openspaceaarhus/PhotonSaw/misc/microsd.png

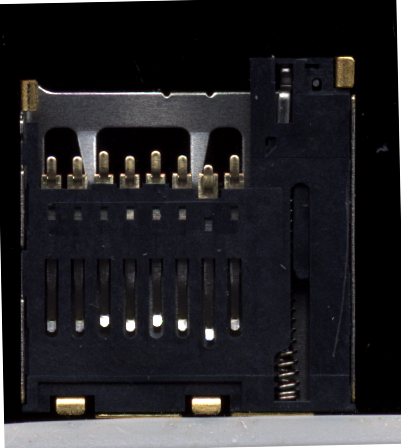
misc/microsd.png
