openspaceaarhus/PhotonSaw/laserctrl/output/tapeout-2011-12-18/pcb-scans.jpeg

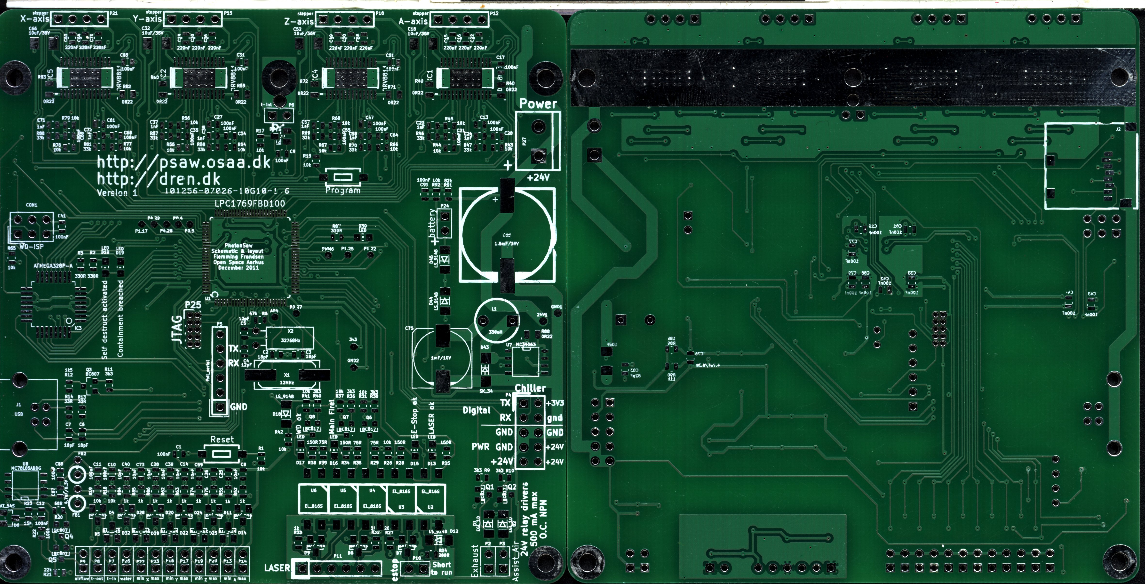
laserctrl/output/tapeout-2011-12-18/pcb-scans.jpeg
