openspaceaarhus/PhotonSaw/README

This is the source tree for the OSAA Laser Cutter, named PhotonSaw.
