openspaceaarhus/PhotonSaw/bulkhead/readme.txt

This is a breakout board which is mounted in the bulkhead between
the electronics comparment and the cutting comparment.

It allows all the connections from the cutting system to be terminated at
the same place and it makes the connection air tight.
