openspaceaarhus/PhotonSaw/host/casing/readme.txt

The engraving on the case does not end up in the correct location,
but all the cuts do.
