openspaceaarhus/PhotonSaw/host/hardware-notes.txt

Screen on hand:
 Samsung 204b: 30.1 x 41.3 cm
 Need a touch panel.
