openspaceaarhus/PhotonSaw/chassis/plates/ready/list.txt

lift.plate.svg				4x	4 mm Al
motor-mount.plate.svg			7x	4 mm Al
idler.plate.svg				6x	4 mm Al
lift-bottom-left.plate.svg		2x	4 mm Al
lift-bottom-right.plate.svg		2x	4 mm Al
x-end.plate.svg				2x	4 mm Al
x-plate.svg				1x	4 mm Al
mirror-1.plate.svg			1x	4 mm Al
mirror-2-x.plate.svg			1x	4 mm Al
mirror-2-z.plate.svg			1x	4 mm Al
mirror-3.plate.svg			1x	4 mm Al
laserctrl-cooling.plate.svg		1x	4 mm Al

tube-mount.plate.svg			2x	6 mm plastic (Nylon/POM/ABS)
