openspaceaarhus/PhotonSaw/chassis/cutlist.ods

Type | Qty | Length
Big | 2 | 1875 | 3750
Big | 2 | 740 | 1480 | 5230 | 1.7433333333
Lit | 2 | 430 | 860
Lit | 2 | 590 | 1180
Lit | 6 | 740 | 4440
Lit | 6 | 1875 | 11250
Lit | 2 | 160 | 320
Lit | 2 | 220 | 440 | 18490 | 6.1633333333
