openspaceaarhus/PhotonSaw/chassis/ramme-v1.1.png

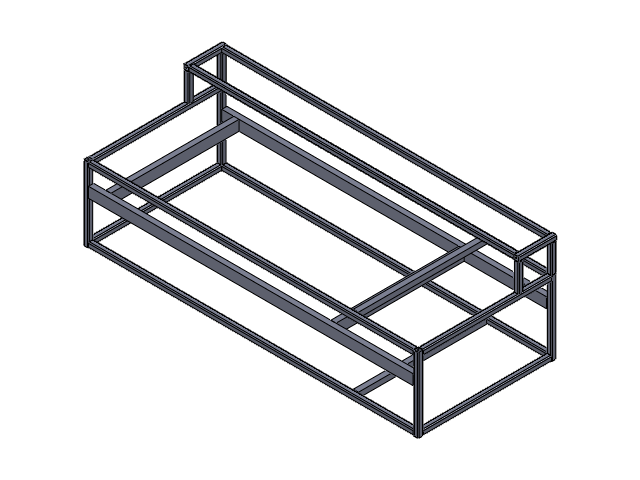
chassis/ramme-v1.1.png
