openspaceaarhus/PhotonSaw/misc/lasercrtl-bom.ods

Sheet: Sheet1
Value | Parts | SKU | # | 1 pcs | n pcs | URL | Extended price
Need from ELFA
mini-sw-CB00.5 | SW1, SW2 | 35-603-98 | 2 | 2.69 | 1.2 | https://www.elfa.se/elfa3~dk_en/elfa/init.do?item=35-603-98 | 2.4
USB USB_B | J1 | 42-707-40 | 1 | 12.1 | 6.64 | https://www.elfa.se/elfa3~dk_en/elfa/init.do?item=42-707-40 | 6.64
MICROSD microSD | J2 | 48-081-00 | 1 | 16 | 12.5 | https://www.elfa.se/elfa3~dk_en/elfa/init.do?item=48-081-00 | 12.5
Power bornier2 | P27 | 48-410-87 | 1 | 5.08 | 3.96 | https://www.elfa.se/elfa3~dk_en/elfa/init.do?item=48-410-87 | 3.96
330uH INDUCTOR_V | L1 | 58-578-19 | 1 | 11.3 | 7.09 | https://www.elfa.se/elfa3~dk_en/elfa/init.do?item=58-578-19 | 7.09
FILTER axial | FB1 FB2 | 58-727-59 | 2 | 1.8 | 1.12 | https://www.elfa.se/elfa3~dk_en/elfa/init.do?item=58-727-59 | 2.24
100k 0603 | R22 | 60-352-40 | 100 | 0.0075 | 0.0075 | https://www.elfa.se/elfa3~dk_en/elfa/init.do?item=60-352-40 | 0.75
150R 0603 | R25 R28 R34 R38 | 60-352-65 | 100 | 0.0075 | 0.0075 | https://www.elfa.se/elfa3~dk_en/elfa/init.do?item=60-352-65 | 0.75
33R 0603 | R13 R14 | 60-596-69 | 2 | 0.555 | 0.276 | https://www.elfa.se/elfa3~dk_en/elfa/init.do?item=60-596-69 | 0.552
68R 0603 | R20 | 60-596-77 | 1 | 0.555 | 0.276 | https://www.elfa.se/elfa3~dk_en/elfa/init.do?item=60-596-77 | 0.276
75R 0603 | R29 R35 R39 | 60-596-78 | 3 | 0.555 | 0.276 | https://www.elfa.se/elfa3~dk_en/elfa/init.do?item=60-596-78 | 0.828
200R 0603 | R24 R27 | 60-596-88 | 2 | 0.555 | 0.276 | https://www.elfa.se/elfa3~dk_en/elfa/init.do?item=60-596-88 | 0.552
330R 0603 | R2 R3 R87 | 60-596-93 | 3 | 0.555 | 0.276 | https://www.elfa.se/elfa3~dk_en/elfa/init.do?item=60-596-93 | 0.828
1k 0603 | R32 R33 R51 R52 R62 R63 R74 R75 R85 R86 R94 | 60-597-05 | 100 | 0.555 | 0.276 | https://www.elfa.se/elfa3~dk_en/elfa/init.do?item=60-597-05 | 27.6
1k5 0603 | R12 | 60-597-09 | 1 | 0.555 | 0.276 | https://www.elfa.se/elfa3~dk_en/elfa/init.do?item=60-597-09 | 0.276
3k3 0603 | R9 R10 R11 R30 R36 R40 | 60-597-17 | 6 | 0.555 | 0.276 | https://www.elfa.se/elfa3~dk_en/elfa/init.do?item=60-597-17 | 1.656
10k 0603 | R1 R15 R17 R18 R19 R26 R31 R37 R41 R42 R43 R44 R45 R54 R55 R56 R65 R66 R67 R68 R77 R78 R79 R92 | 60-597-29 | 100 | 0.555 | 0.276 | https://www.elfa.se/elfa3~dk_en/elfa/init.do?item=60-597-29 | 27.6
11k 0603 | R90 | 60-597-30 | 1 | 0.555 | 0.276 | https://www.elfa.se/elfa3~dk_en/elfa/init.do?item=60-597-30 | 0.276
15k 0603 | R23 | 60-597-33 | 1 | 0.555 | 0.276 | https://www.elfa.se/elfa3~dk_en/elfa/init.do?item=60-597-33 | 0.276
18k 0603 | R89 | 60-597-35 | 1 | 0.555 | 0.276 | https://www.elfa.se/elfa3~dk_en/elfa/init.do?item=60-597-35 | 0.276
22k 0603 | R21 | 60-597-37 | 1 | 0.555 | 0.276 | https://www.elfa.se/elfa3~dk_en/elfa/init.do?item=60-597-37 | 0.276
33k 0603 | R46 R47 R57 R58 R69 R70 R80 R81 | 60-597-41 | 8 | 0.555 | 0.276 | https://www.elfa.se/elfa3~dk_en/elfa/init.do?item=60-597-41 | 2.208
47k 0603 | R6 | 60-597-45 | 1 | 0.555 | 0.276 | https://www.elfa.se/elfa3~dk_en/elfa/init.do?item=60-597-45 | 0.276
82k 0603 | R91 | 60-597-51 | 1 | 0.555 | 0.276 | https://www.elfa.se/elfa3~dk_en/elfa/init.do?item=60-597-51 | 0.276
100nF 0603 | C1 C9 C10 C11 C12 C13 C17 C19 C20 C21 C27 C31 C33 C34 C35 C41 C42 C43 C44 C47 C51 C54 C55 C61 C65 C68 C69 C77 C79 C81 C88 C89 C91 | 65-200-01 | 100 | 0.209 | 0.0963 | https://www.elfa.se/elfa3~dk_en/elfa/init.do?item=65-200-01 | 9.63
220nF 0603 | C15 C16 C22 C29 C30 C36 C49 C50 C56 C63 C64 C70 | 65-721-02 | 12 | 0.788 | 0.411 | https://www.elfa.se/elfa3~dk_en/elfa/init.do?item=65-721-02 | 4.932
4.7uF/6.3V 0603 | C76 C87 | 65-721-05 | 2 | 1.14 | 0.593 | https://www.elfa.se/elfa3~dk_en/elfa/init.do?item=65-721-05 | 1.186
12pF 0603 | C4 C5 | 65-750-05 | 2 | 2.21 | 0.183 | https://www.elfa.se/elfa3~dk_en/elfa/init.do?item=65-750-05 | 0.366
18pF 0603 | C2 C3 C6 C7 | 65-750-47 | 4 | 1.76 | 0.146 | https://www.elfa.se/elfa3~dk_en/elfa/init.do?item=65-750-47 | 0.584
82pF 0603 | C83 | 65-752-03 | 1 | 2.13 | 0.176 | https://www.elfa.se/elfa3~dk_en/elfa/init.do?item=65-752-03 | 0.176
1nF 0603 | C23 C24 C37 C38 C57 C58 C71 C72 | 65-804-11 | 8 | 0.175 | 0.0657 | https://www.elfa.se/elfa3~dk_en/elfa/init.do?item=65-804-11 | 0.5256
10nF 0603 | C8 C14 C25 C26 C28 C39 C40 C59 C73 | 65-804-17 | 100 | 0.175 | 0.0657 | https://www.elfa.se/elfa3~dk_en/elfa/init.do?item=65-804-17 | 6.57
1mF/10V c_elec_10x10 | C75 | 67-226-56 | 1 | 6.72 | 2.99 | https://www.elfa.se/elfa3~dk_en/elfa/init.do?item=67-226-56 | 2.99
1.5mF/35V c_elec_16x16 | C85 | 67-226-96 | 4 | 1.87 | 1.27 | https://www.elfa.se/elfa3~dk_en/elfa/init.do?item=67-226-96 | 5.08
SK34 diode-SMA | D43 | 70-087-07 | 1 | 1.2 | 0.75 | https://www.elfa.se/elfa3~dk_en/elfa/init.do?item=70-087-07 | 0.75
BAT54S diode-SOT23 | D3 D4 D5 D6 D7 D8 D9 D11 D14 D20 D22 D24 D25 D28 D29 D32 | 70-181-38 | 20 | 0.83 | 0.53 | https://www.elfa.se/elfa3~dk_en/elfa/init.do?item=70-181-38 | 10.6
EGL 1D | D1 D2 | 70-035-47 | 6 |  | 0.53 | https://www.elfa.se/elfa3~dk_en/elfa/init.do?item=70-035-38 | 3.18
LS914B diode-minimelf | D12 D18 D44 D45 | 70-186-09 | 10 | 0.42 | 0.21 | https://www.elfa.se/elfa3~dk_en/elfa/init.do?item=70-186-09 | 2.1
BC817 SOT23-bec | Q1 Q2 Q6 Q7 Q8 | 71-311-95 | 10 | 0.338 | 0.233 | https://www.elfa.se/elfa3~dk_en/elfa/init.do?item=71-311-95 | 2.33
BC807 SOT23-bec | Q3 Q4 Q5 | 71-311-98 | 10 | 0.409 | 0.281 | https://www.elfa.se/elfa3~dk_en/elfa/init.do?item=71-311-98 | 2.81
MC78L05ABDG SO8N | U8 | 73-286-67 | 2 | 3.06 | 2.24 | https://www.elfa.se/elfa3~dk_en/elfa/init.do?item=73-286-67 | 4.48
32768Hz QMONTRE | X2 | 74-518-95 | 1 | 2.84 | 1.57 | https://www.elfa.se/elfa3~dk_en/elfa/init.do?item=74-518-95 | 1.57
12MHz Q_49U3HMS | X1 | 74-528-02 | 1 | 9.55 | 5.75 | https://www.elfa.se/elfa3~dk_en/elfa/init.do?item=74-528-02 | 5.75
LED LED-0805 | D10 D13 D15 D16 D17 D19 D30 | 75-102-55 | 10 | 0.88 | 0.52 | https://www.elfa.se/elfa3~dk_en/elfa/init.do?item=75-102-55 | 5.2
EL816S(TA) dip-4 | U2 U3 U4 U5 U6 | 75-390-25 | 5 | 2.24 | 1.35 | https://www.elfa.se/elfa3~dk_en/elfa/init.do?item=75-390-25 | 6.75
JTAG header-1.27mm-2x5 | P25 | 43-914-12 | 2 |  | 6.2 | https://www.elfa.se/elfa3~dk_en/elfa/init.do?item=43-914-12 | 12.4
JTAG socket | n/a | 43-914-00 | 2 |  | 8.58 | https://www.elfa.se/elfa3~dk_en/elfa/init.do?item=43-914-00 | 17.16
1x2 socket | n/a | 43-566-06 | 30 |  | 0.441 | https://www.elfa.se/elfa3~dk_en/elfa/init.do?item=43-566-06 | 13.23
1x4 socket | n/a | 43-566-10 | 10 |  | 0.852 |  | 8.52
1x6 socket | n/a | 43-566-14 | 3 |  | 1.23 |  | 3.69
crimp socket | n/a | 43-010-16 | 128 |  | 0.367 |  | 46.976
Wire – black | n/a | 55-228-00 | 50 |  | 1.35 |  | 67.5
Wire – brown | n/a | 55-228-18 | 50 |  | 1.35 |  | 67.5
Wire – red | n/a | 55-228-26 | 50 |  | 1.35 |  | 67.5
Wire – Orange | n/a | 55-228-34 | 50 |  | 1.35 |  | 67.5
Wire – Yellow | n/a | 55-228-42 | 25 |  | 1.35 |  | 33.75
Wire – Green | n/a | 55-228-59 | 25 |  | 1.35 |  | 33.75
Spiral sleeve | n/a | 55-002-10 | 1 |  | 64.8 |  | 64.8
 |  |  |  |  |  |  | 0
 |  |  |  |  |  |  | 0
 |  |  |  |  |  |  | 0
 |  |  |  |  |  |  | 0
 |  |  |  |  |  |  | 0
 |  |  |  |  |  |  | 0
Need from mouser: |  |  |  |  |  |  | 0
LPC1769FBD100 TQFP_100 | U1 | 771-LPC1769FBD100551 | 1 |  | 58.238 | http://eu.mouser.com/ProductDetail/NXP/LPC1769FBD100551/?qs=sSXnapcmqSv%252bz8p9xNDnBw%3d%3d | 58.238
10uF/35V 1206 | C18 C32 C52 C66 C84 | 810-C3216X6S1V106M | 5 |  | 2.14 | http://eu.mouser.com/ProductDetail/TDK/C3216X6S1V106M/ | 10.7
 |  |  |  |  |  |  | 0
Have from mouser |  |  |  |  |  |  | 0
DRV8811 HTSSOP | IC1 IC2 IC4 IC5 | 595-DRV8811PWP | 4 |  | 37.592 | http://eu.mouser.com/ProductDetail/Texas-Instruments/DRV8811PWP/?qs=sGAEpiMZZMs7zYnFw9eWkg2x1%252beWxeL7 | 150.368
ATMEGA328P-A TQFP32 | IC3 | 556-ATMEGA328P-AU | 1 |  | 31.524 | http://eu.mouser.com/ProductDetail/Atmel/ATMEGA328P-AU/?qs=sGAEpiMZZMtVoztFdqDXO3RbBx7FKCmV | 31.524
0R22 0805 | R48 R49 R59 R60 R71 R72 R82 R83 R88 | have | 9 |  | 0.9176 | http://eu.mouser.com/ProductDetail/Panasonic-Electronic-Components/ERJ-6BQFR22V/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 | 8.2584
 |  |  |  |  |  |  | 0
 |  |  |  |  |  |  | 0
Have from ebay |  |  |  |  |  |  | 0
MC34063 SO8N | U7 | have | 1 |  | 5 | ebay | 5
 |  |  |  |  |  | Total | 946.286
 |  |  |  |  |  | Total incl. Moms | 1182.8575

Sheet: Sheet2
SKU | # | a | Pris | Value
35-603-98 | 2 | 1.2 | 2.4 | mini-sw-CB00.5
42-707-40 | 1 | 6.64 | 6.64 | USB USB_B
48-081-00 | 1 | 12.5 | 12.5 | MICROSD microSD
48-375-06 | 1 | 3.96 | 3.96 | Power bornier2 | Blargh
58-578-29 | 1 | 7.09 | 7.09 | 330uH INDUCTOR_V | Blargh
58-727-59 | 2 | 1.12 | 2.24 | FILTER axial
60-352-40 | 100 | 0.0075 | 0.75 | 100k 0603
60-352-65 | 100 | 0.0075 | 0.75 | 150R 0603
60-596-69 | 2 | 0.276 | 0.552 | 33R 0603
60-596-77 | 1 | 0.276 | 0.276 | 68R 0603 | Mangler
60-596-78 | 3 | 0.276 | 0.828 | 75R 0603
60-596-88 | 2 | 0.276 | 0.552 | 200R 0603
60-596-93 | 3 | 0.276 | 0.828 | 330R 0603
60-597-05 | 100 | 0.276 | 27.6 | 1k 0603
60-597-09 | 1 | 0.276 | 0.276 | 1k5 0603
60-597-17 | 6 | 0.276 | 1.656 | 3k3 0603
60-597-29 | 100 | 0.276 | 27.6 | 10k 0603
60-597-30 | 1 | 0.276 | 0.276 | 11k 0603
60-597-33 | 1 | 0.276 | 0.276 | 15k 0603
60-597-35 | 1 | 0.276 | 0.276 | 18k 0603
60-597-37 | 1 | 0.276 | 0.276 | 22k 0603
60-597-41 | 8 | 0.276 | 2.208 | 33k 0603
60-597-45 | 1 | 0.276 | 0.276 | 47k 0603
60-597-51 | 1 | 0.276 | 0.276 | 82k 0603
65-200-01 | 100 | 0.0963 | 9.63 | 100nF 0603
65-721-02 | 12 | 0.411 | 4.932 | 220nF 0603
65-721-05 | 2 | 0.593 | 1.186 | 4.7uF/6.3V 0603
65-750-05 | 2 | 0.183 | 0.366 | 12pF 0603
65-750-47 | 4 | 0.146 | 0.584 | 18pF 0603
 | 1 | 0.176 | 0.176 | 82pF 0603 | Blargh stak: af 2x47 pF (65-754-72)
65-804-11 | 8 | 0.0657 | 0.5256 | 1nF 0603
65-804-17 | 100 | 0.0657 | 6.57 | 10nF 0603
67-226-56 | 1 | 2.99 | 2.99 | 1mF/10V c_elec_10x10
67-226-96 | 4 | 1.27 | 5.08 | 1.5mF/35V c_elec_16x16
70-087-07 | 1 | 0.75 | 0.75 | SK34 diode-SMA | Mangler
70-181-38 | 20 | 0.53 | 10.6 | BAT54S diode-SOT23
70-035-47 | 6 | 0.53 | 3.18 | EGL 1D
70-186-09 | 10 | 0.21 | 2.1 | LS914B diode-minimelf
71-311-95 | 10 | 0.233 | 2.33 | BC817 SOT23-bec
71-303-62 | 10 | 0.51 | 5.1 | BC807 SOT23-bec | Blargh
73-286-67 | 2 | 2.24 | 4.48 | MC78L05ABDG SO8N
74-518-95 | 1 | 1.57 | 1.57 | 32768Hz QMONTRE
74-528-02 | 1 | 5.75 | 5.75 | 12MHz Q_49U3HMS
75-102-55 | 10 | 0.52 | 5.2 | LED LED-0805
75-390-25 | 5 | 1.35 | 6.75 | EL816S(TA) dip-4
43-914-12 | 2 | 6.2 | 12.4 | JTAG header-1.27mm-2x5
43-914-00 | 2 | 8.58 | 17.16 | JTAG socket
43-566-06 | 30 | 0.441 | 13.23 | 1x2 socket
43-566-10 | 10 | 0.852 | 8.52 | 1x4 socket
43-566-14 | 3 | 1.23 | 3.69 | 1x6 socket
43-010-16 | 128 | 0.367 | 46.976 | crimp socket
55-228-00 | 50 | 1.35 | 67.5 | Wire – black
55-228-18 | 50 | 1.35 | 67.5 | Wire – brown
55-228-26 | 50 | 1.35 | 67.5 | Wire – red
55-228-34 | 50 | 1.35 | 67.5 | Wire – Orange
55-228-42 | 25 | 1.35 | 33.75 | Wire – Yellow
55-228-59 | 25 | 1.35 | 33.75 | Wire – Green
55-002-10 | 1 | 64.8 | 64.8 | Spiral sleeve
 | Total |  | 684.4876
 | Incl. Moms | moms | 855.6095
