openspaceaarhus/PhotonSaw/misc/expenses-and-sources.ods

Sheet: Expences
ID | Subsystem | Part | Budget | Actual | Paid by
./rain | LASER+cooling | LASER + PSU + spare optics |  | 4000 | Cash
2021 |  | Transport of LASER |  | 1050 | ff | Bridge and fuel
2022 |  | HV wire |  | 145 | ff
2023 |  | Water cooling fittings |  | 125 | ff
2024 |  | Flow sensor |  | 200 | ff
2025 |  | Pump |  | 434 | ff
2026 |  | More fittings |  | 362 | ff
2027 |  | Hose clamps |  | 85 | ff | Brix bought them
2028 |  | Pump + fittings for chiller |  | 848 | ff | This should be the last cooling gear needed.
2050 |  | Yet more fittings |  | 143 | ff | ... no this is.
2051 |  | Yet more fittings |  | 121 | ff | ... no this!
2052 |  | Tank 2.5 L |  | 63.75 | ff
2053 |  | Insulation |  | 89 | ff
2054 |  | rubber gaskets |  | 38 | ff
2055 |  | HN safety glasses |  | 130 | ff
2029 | Optics | Optics kit from Ebay |  | 1462 | ff | Got it – 1 mirror
 | Mechanics
2030 |  | V-rails from Klee |  | 1080 | ff | http://www.klee.dk/catalog/group/nodeid/dualv_skin
2031 |  | V-groove bearings |  | 540 | ff | http://www.vxb.com/page/bearings/PROD/Kit8351
2032 |  | MayTec – profiles |  | 3353 | ff
2033 |  | MayTec – connectors |  | 1121 | ff | http://www.maytec.org/mainframe_e.htm
2034 |  | Toothed belts and pulleys |  | 730 | ff | http://www.mobra.biz/sw/frontend/show.asp?parent=151030&layout=0
2144 |  | IGUS cable chains |  | 323 | ff
 |  | PETG windows | 620 |  |  | BS plast
 |  | Skins (1mm alu) | 1630 |  |  | Sanistål
2035 | OSB møbel | 5x OSB + 4x Reglar + Skruer |  | 732.22 | ff
2036 | Tools | Lathe tools |  | 386 | ff
2037 |  | Misc tools (HN 2011.11.08) |  | 715 | ff
2038 |  | LPC1769 proto boards |  | 440 | ff | http://www.embeddedartists.com/products/lpcxpresso/lpc1769_xpr.php
2039 |  | Small plate bending brake |  | 320 | ff | http://www.warco.co.uk/box-pan-folders-sheet-metal-machinery-benders/89-vice-brake.html
2040 |  | More tools (BH 12/11) |  | 249 | ff
2041 | Electronics | ATmega328 + drv8811 |  | 618 | ff
2042 |  | Steppers x 3 |  | 460 | ff | Brix bought them
2043 |  | 40x 100 MOhm resistors |  | 364 | ff
2044 |  | iTead PCB v 1 |  | 200 | ff
 |  | ELFA main board parts | 900 |  | ff
2056 |  | ELFA wires |  | 77 | ff
2057 |  | ELFA NTC |  | 58 | ff
2158 |  | Digikey via Asbjørn (ARM) |  | 238 | asbjørn | Asbjørn did it.
 |  | Total | 3150 | 21299.97 | 24449.97
 |  |  |  |  |  | Finansing needed after
 |  | Sponsored | Externally |  | 19000 | 5449.97
 |  |  | Internally |  | 7767
 |  |  | Total |  | 26767 | -2317.03

Sheet: Sponsors
Sponsor | Amount
Stibo A/S | 15000
IHA | 4000
TOTAL External: |  | 19000
Flemming Frandsen | 2567 |  | 2567
Christian Perti | 2000 |  | 2000
Asbjørn Tølbøl Brask | 500 |  | 500
Kasper Jensen | 500 |  | 500
Rune B. Broberg | 500 |  | 500
Knud Jørgensen | 500 |  | 500
Duo-Design | 500 |  | 500
Torben Lund Jensen | 500 |  | 500
Kristian Møller Bodeholt | 200
TOTAL Internal |  | 7767
TOTAL sponsored |  | 26767
Cash sponsored – 4k LASER |  |  | 3567
