openspaceaarhus/PhotonSaw/aiming-shutter/mirror-holder.step

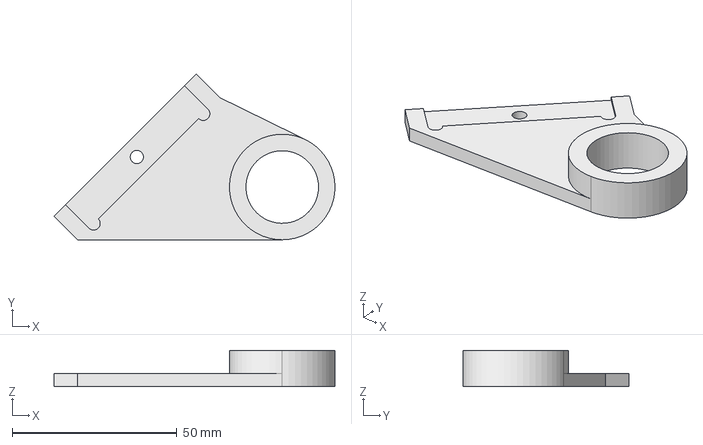
[picture p9: CAD file, 2020-03-10]
aiming-shutter/mirror-holder.step
85.2 x 50.2 x 11.0 mm
