openspaceaarhus/PhotonSaw/chassis/photonsaw-chassis-1.FCStd

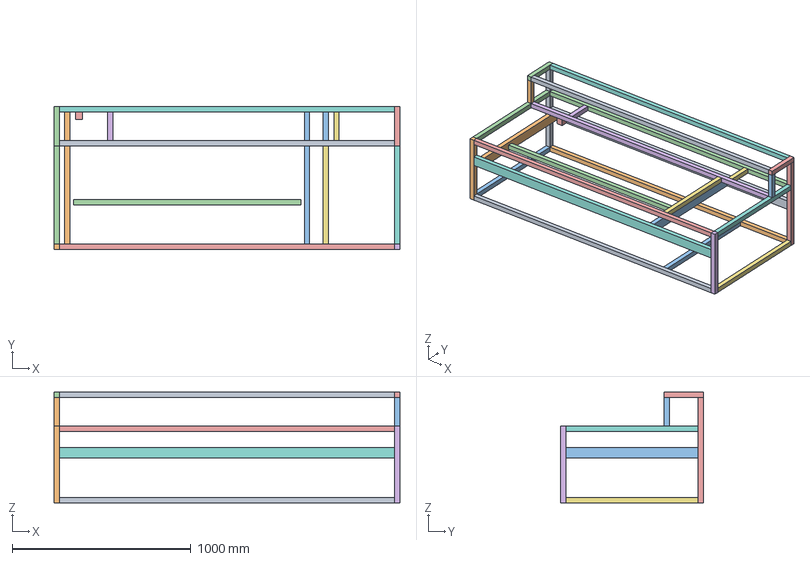
[picture p10: CAD file, 2012-01-12]
chassis/photonsaw-chassis-1.FCStd
1935.0 x 800.0 x 620.0 mm
Left Rear pillar
Left Front pillar
Left Bottom beam
Left Top beam
Right Rear pillar
Right Front pillar
Right Bottom beam
Right Top beam
Bottom Front beam
Bottom Rear beam
Bottom Firewall beam
Top Rear beam
Top Front beam
Top Mid beam
Top Firewall front beam
Laser box rear beam
Laser box front beam
Laser box left pillar
Laser box right pillar
laser box left top
laser box right top
laser box floor left
laser box floor right
Motion front beam
Motion rear beam
Motion Left Y axis
Motion Right Y axis
Motion X axis
Y Motor Left
