openspaceaarhus/PhotonSaw/chassis/ramme-v1.1.sldprt

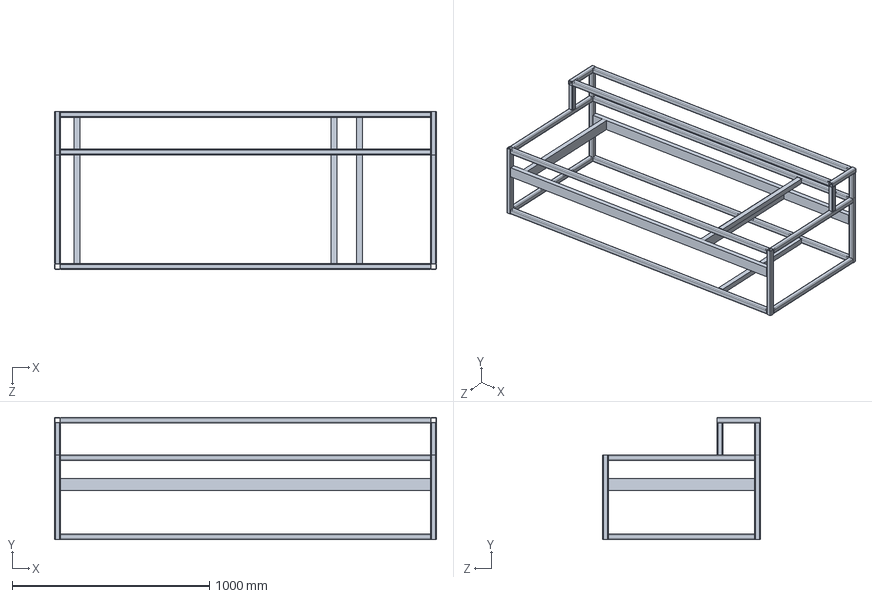
[picture p11: CAD file, 2011-12-21]
chassis/ramme-v1.1.sldprt
1935.0 x 620.0 x 800.0 mm
