openspaceaarhus/PhotonSaw/aiming-shutter/hest.dxf

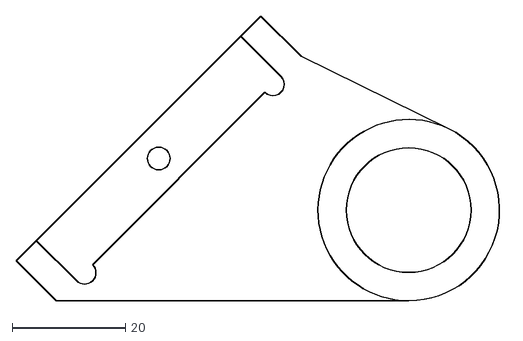
[picture p12: CAD file, 2020-03-10]
aiming-shutter/hest.dxf
86.5 x 50.2
