openspaceaarhus/PhotonSaw/(list of files, cad)

Other CAD files:
aiming-shutter/mirror-plate.stl
aiming-shutter/aiming-shutter.fcstd
