openspaceaarhus/PhotonSaw/host/testdata/onebit.png

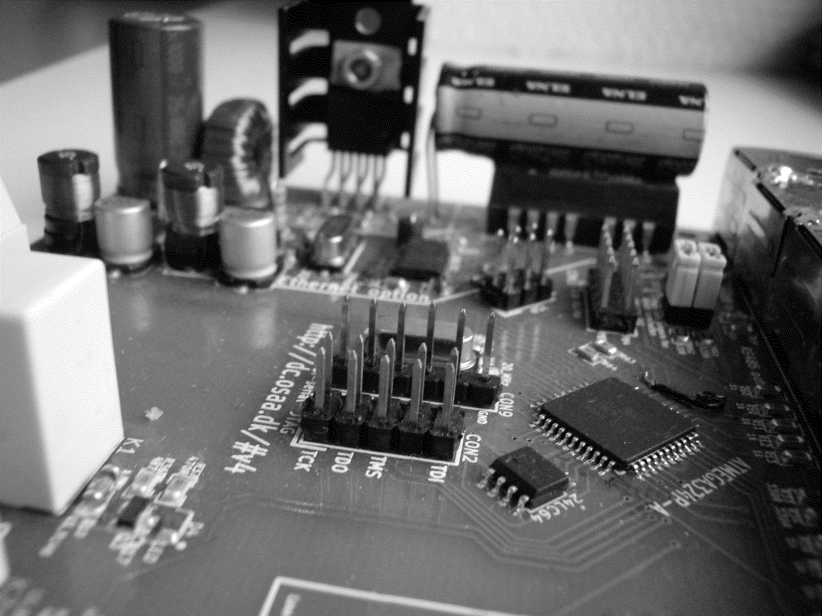
host/testdata/onebit.png
