openspaceaarhus/PhotonSaw/host/testdata/zoid.png

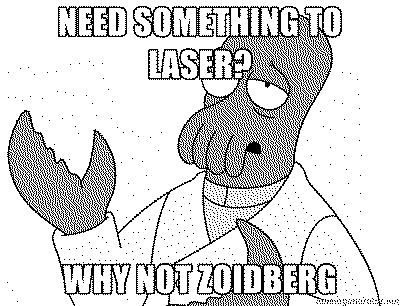
host/testdata/zoid.png
