openspaceaarhus/PhotonSaw/bulkhead/bulkhead.sch

## KiCad design bulkhead/bulkhead.sch (2012-07-22)

Schematic: bulkhead.sch

Parts:
P1: x-in
P2: x-motor
P3: z-in
P4: z-m0
P5: input
P6: x-max
P7: z-m1
P8: x-min
P9: z-m2
P10: y-in
P11: y-right
P12: z-m3
P13: Airflow
P14: Temp-out
P15: Z-max
P16: y-left
P17: Temp-in
P18: Z-min
P19: y-max
P20: Waterflow
P21: y-min
P22: A-in
P23: A-axis
P24, P25, P26, P27: CONN_1

Notes on the sheet:
Main input connector, placed on backside of board
