openspaceaarhus/PhotonSaw/laserctrl/driver.sch

## KiCad design laserctrl/driver.sch (2020-03-10, an earlier design)

Schematic: driver.sch

Parts:
C13, C17, C20, C21: 100nF
C15, C16, C22: 220nF
C18: 10uF/35V
C23, C24: 1nF
C25, C28: 10nF
D28, D29: BAT 54S
IC1: DRV8811
P12: stepper
P13: min
P14: max
R43, R44, R45: 10k
R46, R47: 33k
R48, R49: 0R22
R51, R86: 1k

Notes on the sheet:
Stepper motor connector
