openspaceaarhus/PhotonSaw/laserctrl/laser.sch

## KiCad design laserctrl/laser.sch (2020-03-10, an earlier design)

Schematic: laser.sch

Parts:
D7, D8, D9: BAT 54S
D12, D18: LS 914B
D13, D15, D16, D17: LED
P10: estop
P11: LASER
Q6, Q7, Q8: BC817
R24, R27: 200R
R25, R28, R34, R38: 150R
R26, R31, R37, R41, R42: 10k
R29, R35, R39: 75R
R30, R36, R40: 3k3
R32, R33: 1k
U2, U3, U4, U5, U6: EL 816S(TA)

Notes on the sheet:
Note: All LEDS on => LASER fires
Emergency Stop. Short to run
+5V out
Modulation
GND
~Enable
~Enable (pull down)
