openspaceaarhus/PhotonSaw/laserctrl/laserctrl.sch

## KiCad design laserctrl/laserctrl.sch (2020-03-10, an earlier design)

Schematic: laserctrl.sch

Parts:
3v3, 24V1: CONN_1
AD4: CONN_1
C2, C3: 18pF
C4, C5: 12pF
GND1, GND2: CONN_1
P0.4, P0.5, P0.27, P1.17, P1.22, P1.25, P4.28, P4.29: CONN_1
P25: JTAG
PWM6: CONN_1
R6: 47k
U1: LPC1769FBD100
X1: 12MHz
X2: 32768Hz

Notes on the sheet:
1.27 mm pitch ARM JTAG/SWD connector
Unused pins terminated at solder pads on PCB
Supply voltage sense (10.8696 %)
SD card
Chiller serial port
ISP+debug serial port
Watchdog serial port
JTAG
Internal temp
laser-in
laser-out
Airflow
LASER PWM
A Current
Z Current
Y Current
X Current
