openspaceaarhus/PhotonSaw/laserctrl/psu.sch

## KiCad design laserctrl/psu.sch (2020-03-10, an earlier design)

Schematic: psu.sch

Parts:
C19, C33, C42, C77, C79, C81, C88, C89, C91: 100nF
C75: 1mF/10V
C76, C87: 4.7uF/6.3V
C83: 82pF
C84: 10uF/35V
C85: 1.5mF/35V
D43: SK 34
D44, D45: LS 914B
FB1, FB2: FILTER
H1, H2, H3, H4, H5: MOUNTING
L1: 330uH
P24: battery
P27: Power
R88: 0R22
R89: 18k
R90: 11k
R91: 82k
R92: 10k
U7: MC34063
U8: MC78L05ABDG

Notes on the sheet:
Note: The +5V supply is only used for NTCs it needs to supply only a few mA of current
3mm mounting holes at the corners of the board and heatsink
Distributed decoupling caps
