openspaceaarhus/PhotonSaw/laserctrl/sd-isp.sch

## KiCad design laserctrl/sd-isp.sch (2020-03-10, an earlier design)

Schematic: sd-isp.sch

Parts:
C1: 100nF
C6, C7: 18pF
D1, D2: EGL 1D
D30: LED
J1: USB
J2: MICROSD
P2: Exhaust
P3: Assist Air
P4: Chiller
P5: ftdi serial
Q1, Q2: BC817
Q3: BC807
R1, R15: 10k
R9, R10, R11: 3k3
R12: 1k5
R13, R14: 33R
R87: 330R
SW1: Program
SW2: Reset

Notes on the sheet:
Note: wire 4 sits on the 3.3V logic ground, 5,6,7 sits on unregulated 24V ground.
