openspaceaarhus/PhotonSaw/laserctrl/temp-sensors.sch

## KiCad design laserctrl/temp-sensors.sch (2020-03-10, an earlier design)

Schematic: temp-sensors.sch

Parts:
C9, C10, C11, C12: 100nF
C40: 10nF
D3, D4, D5, D6, D32: BAT 54S
P1: CONN_1
P6: t-int
P7: t-in
P8: t-out
P9: airflow
P26: waterflow
Q4, Q5: BC807
R17, R18, R19: 10k
R20: 68R
R21: 22k
R22: 100k
R23: 15k
R94: 1k

Notes on the sheet:
Self-heating NTC placed in air flow
10mA constant current
