openspaceaarhus/PhotonSaw/laserctrl/watchdog.sch

## KiCad design laserctrl/watchdog.sch (2020-03-10, an earlier design)

Schematic: watchdog.sch

Parts:
C41, C43, C44: 100nF
CON1: WD-ISP; AVR-ISP-6
D10, D19: LED
IC3: ATMEGA328P-A; TQFP32
R2, R3: 330R
R65: 10k
