openspaceaarhus/PhotonSaw/(commit log)

2011-10-22 Started the schematic for the laser controller, mainly missing some connectors
    [driver.sch, laserctrl.sch, psu.sch]
2011-10-22 Deleted the A-axis, it's getting too cramped with limited 328 I/O
    [driver.sch, laserctrl.sch, psu.sch]
2011-10-23 Started with the LPC1769
    [watchdog.sch]
2011-10-23 Started work on ARM 32
    [driver.sch, laserctrl.sch, psu.sch, watchdog.sch]
2011-10-25 Started keeping a spreadsheet of the parts
    [expenses-and-sources.ods]
2011-10-26 Added Mobra parts to budget
    [expenses-and-sources.ods]
2011-10-30 Added some more details to expences
    [expenses-and-sources.ods]
2011-10-30 Actually did some work
    [driver.sch, laserctrl.sch, psu.sch, watchdog.sch]
2011-10-31 Added laser interface schematic
    [driver.sch, laser.sch, laserctrl.sch, psu.sch, watchdog.sch]
2011-11-02 Added optocouplers to the LASER interface to protect against induced transients
    [driver.sch, laser.sch, laserctrl.sch, psu.sch, watchdog.sch]
2011-11-03 Added skins to budget
    [expenses-and-sources.ods]
2011-11-04 Added transistors to drive the hungry optocouplers (20 mA) the LPC will only source 2 mA or so
2011-11-04 Added transistors to drive the optocouplers
    [driver.sch, laser.sch, laserctrl.sch, psu.sch, watchdog.sch]
2011-11-05 Added NTC sensors
    [driver.sch, laser.sch, laserctrl.sch, psu.sch, temp-sensors.sch, watchdog.sch]
2011-11-06 Added the chiller and the USB/Serial/ISP/SD subsystems and added some specs on the chiller protocol
    [chiller-if.sch, driver.sch, laser.sch, laserctrl.sch, psu.sch, sd-isp.sch, temp-sensors.sch, watchdog.sch]
2011-11-06 Added a todo list so I don't forget the last bits and tried annotating different ways
    [chiller-if.sch, driver.sch, laser.sch, laserctrl.sch, psu.sch, sd-isp.sch, temp-sensors.sch, watchdog.sch]
2011-11-07 Added relay drivers for exhaust and assist air
    [chiller-if.sch, driver.sch, laser.sch, laserctrl.sch, psu.sch, relays.sch, sd-isp.sch, temp-sensors.sch]
2011-11-07 Added connections to the watchdog
    [chiller-if.sch, driver.sch, laser.sch, laserctrl.sch, psu.sch, relays.sch, sd-isp.sch, temp-sensors.sch]
2011-11-07 Started assigning footprints
    [chiller-if.sch, driver.sch, laser.sch, laserctrl.sch, psu.sch, relays.sch, sd-isp.sch, temp-sensors.sch]
2011-11-08 Start of kicad project
    [Chiller ctl.sch]
2011-11-08 Added chiller test temps
    [Temp test.ods]
2011-11-08 Added microSD symbol and started simplifying a bit
    [chiller-if.sch, driver.sch, laser.sch, laserctrl.sch, psu.sch, relays.sch, sd-isp.sch, temp-sensors.sch]
2011-11-08 Reorganized expences a bit
    [expenses-and-sources.ods]
2011-11-09 Added bending brake to the expences
    [expenses-and-sources.ods]
2011-11-09 Started some cleaning up
    [chiller-if.sch, driver.sch, laser.sch, laserctrl.sch, psu.sch, relays.sch, sd-isp.sch, temp-sensors.sch]
2011-11-09 Use double-shottky diodes in stead of tons of discrete miniMELFs
    [chiller-if.sch, driver.sch, laser.sch, laserctrl.sch, psu.sch, relays.sch, sd-isp.sch, temp-sensors.sch]
2011-11-10 Drew the SD connector
2011-11-10 Added a couple of missing modules
    [driver.sch, laser.sch, laserctrl.brd, laserctrl.sch, psu.sch, sd-isp.sch, temp-sensors.sch, watchdog.sch]
2011-11-11 Added the cooling gear needed to hook up to the chiller
    [expenses-and-sources.ods]
2011-11-11 Added note about the high-voltage probe
2011-11-12 Added foot print for a 5V regulator that I can actually get, added 3-way solder jumper, added waterflow sensor input, pinned out the extra pins
    [driver.sch, laser.sch, laserctrl.sch, psu.sch, sd-isp.sch, temp-sensors.sch, watchdog.sch]
2011-11-12 Fixed a couple of footprints and started thinking about the board layout
    [laserctrl.brd]
2011-11-12 Added parts for the base and proper pop-rivet tool
    [expenses-and-sources.ods]
2011-11-13 Started board space allocation
    [driver.sch, laser.sch, laserctrl.brd, laserctrl.sch, psu.sch, sd-isp.sch, temp-sensors.sch, watchdog.sch]
2011-11-13 Forgot this
    [driver.sch, laser.sch, laserctrl.brd, laserctrl.sch, psu.sch, sd-isp.sch, temp-sensors.sch, watchdog.sch]
2011-11-14 Finished rough board space allocation
    [driver.sch, laser.sch, laserctrl.brd, laserctrl.sch, psu.sch, sd-isp.sch, temp-sensors.sch, watchdog.sch]
2011-11-15 Moved things about a bit
    [driver.sch, laser.sch, laserctrl.brd, laserctrl.sch, psu.sch, sd-isp.sch, temp-sensors.sch, watchdog.sch]
2011-11-16 Added some new, smaller footprints
2011-11-16 Started trying to actually route some tracks
    [driver.sch, laser.sch, laserctrl.brd, laserctrl.sch, psu.sch, sd-isp.sch, temp-sensors.sch, watchdog.sch]
2011-11-18 Started routing the stepper controllers
    [driver.sch, laser.sch, laserctrl.brd, laserctrl.sch, psu.sch, sd-isp.sch, temp-sensors.sch, watchdog.sch]
2011-11-20 Added uart stuff
2011-11-20 Added inital working fw, just say 'ok\n' to everything on uart
2011-11-20 Reordered all GPIO pins on main MCU to fit the perifrials and laid out most of the board
    [driver.sch, laser.sch, laserctrl.brd, laserctrl.sch, psu.sch, sd-isp.sch, temp-sensors.sch, watchdog.sch]
2011-11-21 Routed the rest of the main MCU, starting reorganizing the watchdog
    [driver.sch, laser.sch, laserctrl.brd, laserctrl.sch, psu.sch, sd-isp.sch, temp-sensors.sch, watchdog.sch]
2011-11-21 Finished major routing, still need fixing DRC errors
    [driver.sch, laser.sch, laserctrl.brd, laserctrl.sch, psu.sch, sd-isp.sch, temp-sensors.sch, watchdog.sch]
2011-11-21 Finished DRC, almost, the bottom pads of the HTSSOPs still cause DRC violations
    [laserctrl.brd]
2011-11-23 Redid most of the UART stuff
2011-11-23 Small fix for parser
    [chillerctrl.c]
2011-11-23 Started cosmetic work, silkscreen and board edges
    [laserctrl.brd]
2011-11-24 Did some silkscreen cosmetics
    [driver.sch, laser.sch, laserctrl.brd, laserctrl.sch, psu.sch, sd-isp.sch, temp-sensors.sch, watchdog.sch]
2011-11-25 Optimized layout to move the big cap closer to the stepper drivers
    [laserctrl.brd]
2011-11-27 Added a couple of status LEDs for the watchdog and did some minor tweaking, mainly on the silkscreen
    [driver.sch, laser.sch, laserctrl.brd, laserctrl.sch, psu.sch, sd-isp.sch, temp-sensors.sch, watchdog.sch]
2011-11-28 Minor tweaking
    [driver.sch, laser.sch, laserctrl.brd, laserctrl.sch, psu.sch, sd-isp.sch, temp-sensors.sch, watchdog.sch]
2011-11-29 Minor silkscreen mods
    [laserctrl.brd]
2011-12-04 Generated the BOM and figured out what parts to buy at ELFA and Mouser
    [driver.sch, laser.sch, lasercrtl-bom.ods, laserctrl.brd, laserctrl.sch, psu.sch, sd-isp.sch, temp-sensors.sch]
2011-12-07 Checked footprints and fixed 1 thinko on the ARM and unfucked the transistor foot prints
    [driver.sch, laser.sch, laserctrl.brd, laserctrl.sch, psu.sch, sd-isp.sch, temp-sensors.sch, watchdog.sch]
2011-12-07 Ordered parts at ELFA
    [lasercrtl-bom.ods]
2011-12-15 Fixed microSD card footprint
    [laserctrl.brd]
2011-12-15 Fixed switch footprint
    [lasercrtl-bom.ods, laserctrl.brd]
2011-12-15 Fixed opto coupler footprint
    [laserctrl.brd]
2011-12-17 Fixed footprint for optocouplers some more, layout all fucked up
    [laserctrl.brd]
2011-12-17 Fixed the rest of the footprint issues, the PCB should be good to go now.
    [laserctrl.brd]
2011-12-18 Last fixups and tapeout for version 1
    [laserctrl.brd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]
2011-12-21 Added the cutlist and the crazy solidworks files
    [cutlist.ods, lasercrtl-bom.ods, ramme-v1.1.sldprt]
2011-12-24 Added FreeCAD drawing of chassis
    [photonsaw-chassis-1.FCStd]
2011-12-28 Added transaction ids to all expense lines
    [expenses-and-sources.ods]
2011-12-28 Upped version number on lasercrtl board so v1 is never changed
    [laserctrl.brd]
2011-12-28 Added y motor cube
    [expenses-and-sources.ods, photonsaw-chassis-1.FCStd]
2012-01-07 Added inkscape drawings of nema17 motor foot print and the z-axis motor and bearing mount plate
    [expenses-and-sources.ods]
2012-01-12 Added script to make svg drawings of plates with holes easy and fast
    [photonsaw-chassis-1.FCStd]
2012-01-13 Added a few more plates
2012-01-13 Started some work on adding paths to the svg to allow drawing mounting sketches
2012-01-15 Fixed rotation of modules and made the Mirror 1 mounting plate
2012-01-17 Added the output svg files for some of the plates, chassis/plates/ready/mirror-2-z.plate.svg has been modified by hand to cut away the corner
2012-01-18 Added text file with the sizes of the skin plates
2012-01-18 Added the MCU order to the expences
    [expenses-and-sources.ods]
2012-01-18 Designed the X plate where the head is mounted, still needs to figure out how to attach the cable chain and the belt
2012-01-19 Added missing plate
2012-01-22 Created x-axis end plate
2012-01-22 Trying to compress the motor mounts for the y axis
2012-01-23 Added new end plate for the x end
2012-01-23 Fixed Mirror 1 plate
2012-01-24 Fixed z-lift plates and optimized motor mount size.
2012-01-25 Added rough version of the idler plate
2012-01-26 Finished idler plate
2012-01-27 Added text to the svg output and adjusted the height of the belt-tightning hole
2012-02-02 Changed bearing holes to 3.2 mm to fit M4 threads
2012-02-04 Added pdf of schematic
2012-02-07 Fixed hole diameters for tapping
2012-02-12 Added the script to fetch and build the tool chain
2012-02-12 Fixed hole sizes for M4 threads
2012-02-12 Added the foundation for the LPC1769 based firmware, notice it's 100% based on Open Source and doesn't depend on mbed or Code Sourcery
    [startup_LPC17xx.c, system_LPC17xx.c]
2012-02-13 Starting to work on the uart, having some unroll problems, though
    [system_LPC17xx.c, uart.c]
2012-02-13 Added a terrible, terrible hack to try to get the uart test running, but it's blowing up and gdb doesn't want to single step, aaargh...
    [startup_LPC17xx.c, uart.c]
2012-02-14 Fixed toolchain so it generates code for thumb and actually works, uart works now too
    [startup_LPC17xx.c, uart.c]
2012-02-15 Fixed a few bugs in the nxp usbcdc example and got it working, also fixed a couple of boogs in the laserctrl board for V2
    [driver.sch, laser.sch, laserctrl.brd, laserctrl.sch, psu.sch, sd-isp.sch, temp-sensors.sch, watchdog.sch]
2012-02-15 Changed uart number and now it actually works, whee
2012-02-17 Refactored the framework a bit
2012-02-17 Added dummy watchdog that just toggles its LEDS, outputs and sends OK to allow testing without coding a proper watchdog
2012-02-18 Started the board abstraction code that sets up all the GPIO and other configurable bits
2012-02-19 Fixed some via size problems with the board
    [laserctrl.brd]
2012-02-22 Fixed linker script so the full 64 KB of RAM is available, hacked up some fileio stubs for newlib to write to the uart with and starting to think about importing SD + FAT support from http://www.siwa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
    [uart.c]
2012-02-23 Trying to get the ADC working, but it never completes
2012-02-24 Added the adc drivers
2012-02-25 Made the ADC work in burst mode, which means that it's always running and the latest data is readable from the output registers at any time, it's all somewhat messy and needs refactoring, though
2012-02-26 Verified the ADC inputs and added routines to calculate usable values from the raw ADC values
2012-02-26 Added basic PWM code, PWM frequency is 117 kHz
2012-02-26 Added low level stepper interface and pwm drivers
2012-02-27 Misc minor changes
    [laserctrl.brd]
2012-02-28 Fixed material and hole size for the lift plates to fit the high nuts
2012-02-29 Added cooling plate for the laser ctrl to the chassis plate collection
2012-02-29 Fixed list of ready plates
2012-03-01 Starting interrupt driven uart framework
2012-03-04 Moved the uart code from blocking and unbuffered to non-blocking, buffered, interrupt driven and made the watchdog talk to the main MCU over 19200 baud serial
2012-03-10 Added default values and ADC read function
2012-03-12 Fixed some stepper motor driver pinouts
2012-03-12 Added tube mount plates and added the needed .gitignore files to avoid driving me mad
2012-03-17 Added first bit of cut down usbcdc code
2012-03-18 Made blocking stdio work correctly and made the usbcdc code compile, it's not yet hooked up to anything, though
    [uart.c]
2012-03-20 Wrote down some thoughts on the whole planner vs. stepper problem
2012-04-06 Added ChaNs FAT fs with SD io for the lpc17xx by Martin Thomas: http://www.siwawi.arubi.uni-kl.de/avr_projects/arm_projects/arm_memcards/#chanfat_lpc_cm3 it isn't plumbed into stdio yet, but it will 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
2012-04-07 Moved the UART rx path from blocking stdio to line based callbacks
2012-04-07 Moved the SD card polling routine onto a separate timer, so it doesn't get in the way of the 1kHz systick
    [board.c]
2012-04-08 Implemented most of the realtime stepper code and move code interpreter
2012-04-09 Added code to keep track of the coolant and made it possible to stop the mover and flush the buffer
2012-04-09 Improved status output and fixed alarm logic, fighting strange buffering issue with the USB output though
    [commander.c]
2012-04-10 Tracked down the USB write problems to handling of USB commands in the USB interrupt, baaddefer the usb command processing to a lower level software interrupt in stead
    [mover.c]
2012-04-10 Added some more measurements to the PCB mounting holes and added a plate drawing with the mounting holes
    [laserctrl.brd]
2012-04-13 Switched USB subsystem to lpcusb which is interrupt driven and has a much nicer API, even though it uses hungarian notation internally and that is generally a strong indicator of madness
2012-04-14 Made a move compiler in perl and fixed a couple of move parser bugs
    [commander.c, mover.c]
2012-04-22 Ported the GRBL planner from Smoothie to Java, still needs to wrap my head around converting the output to moves without losing steps
2012-05-02 Did some more restructuring, the planner and the commander now each have a thread one for planning moves, the other for stuffing them through USB
2012-05-06 It's annoying, but it seems the grbl algorithm still outwits me...
2012-05-14 Implemented laser intensity ramping and engraving in Line, but I'm getting move coding errors
2012-05-17 Added ADC readout in MV
2012-07-11 Added slots for the lift nuts
2012-07-14 Added special winged nut hole
2012-07-15 Started implementation of the jog client and the rest api needed for it, the api framework is not complete yet, as I still need to implement the json parser/generator
2012-07-19 Did some messing about to get the Y axis running on the actual machine
2012-07-22 Implemented the json api frame work and started trying to implement a jog function
2012-07-22 Added the bulkhead PCB kicad project
    [bulkhead.brd, bulkhead.sch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]
2012-07-29 Removed the old scalar+angle based feed rate optimizer from grbl and implemented a vector based method from scratch in stead
2012-09-08 Added complete chiller controller schematic
    [Chiller ctl.sch, chillerctrl.sch]
2012-09-08 Added pdf schematic
2012-09-12 Minor fixups on the chiller
    [chillerctrl.sch]
2012-09-23 Finished chiller controller design and hardware, started on the firmware
    [chillerctrl.sch]
2012-09-24 Switched to an LCD framework that actually works
2012-09-24 Consolidated the atmega328, 168 and 88 frameworks into one place and was forced to move the chiller ctrl to an atmega168
    [chillerctrl.sch]
2012-09-25 Did various updates
    [chillerctrl.sch]
2012-09-26 Tried out the controller with the actual hardware and did some fixes, still not working
    [chillerctrl.sch]
2012-09-26 Added warmup state to lessen the power surge by starting the fan a couple of seconds before the compressor
2012-09-26 Removed floating point pid implementation from pwmvoltages, now down to 6386 of flash
2012-09-26 I think all three PID loops have been tuned correctly now and we're down to 6214 bytes of code
    [chillerctrl.c, pwmvoltages.c, pwmvoltages.h]
2012-09-26 Removed every trace of libm and float, result: 4340 bytes (53.0% Full)
2012-09-30 Set the minimum temperature to 10 degrees in stead of -10
2012-09-30 Allocated a bit for setting switches and for the assist air switch
2012-10-03 Implemented bufferable and direct assist air control as well as direct exhaust control and better water flow sensor debounce
2012-10-03 Implemented config option to tell the host software what the maximum power of the laser is
2012-10-04 Added new svg files that have been cut, fixed cooling alarm checks, added missing LaserNodeSettings class
2012-10-08 Fixed placement of holes for the mounting screws
2012-10-08 Added code to explicitly reset the motor drivers when starting up
2012-10-13 Reversed laser pwm output to fit new optocoupler
    [commander.c, laser.h]
2012-10-13 Added datasheets for the new fet and optocoupler
2012-10-13 Changed the fire and modulation optocoupler, removed laser ground to system ground connection, added diode to avoid having the watchdog fire the laser on its own, switched diodes to BAT 54S for easie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
    [driver.sch, laser.sch, laserctrl.sch, psu.sch, sd-isp.sch, temp-sensors.sch, watchdog.sch]
2012-10-13 Wired up the watchdog to the new fire feedback signal
    [driver.sch, laser.sch, laserctrl.sch, psu.sch, sd-isp.sch, temp-sensors.sch, watchdog.sch]
2012-10-14 Did some more rev2 schematic changes
    [driver.sch, laser.sch, laserctrl.sch, psu.sch, sd-isp.sch, temp-sensors.sch, watchdog.sch]
2012-10-14 Completed the schematic changes for rev2 of laserctrl
    [driver.sch, laser.sch, laserctrl.sch, psu.sch, sd-isp.sch, temp-sensors.sch, watchdog.sch]
2012-10-15 Started redoing the PCB
    [auxio.sch, driver.sch, laser.sch, laserctrl.brd, laserctrl.sch, psu.sch, sd-isp.sch, temp-sensors.sch]
2012-10-15 Did some pcb layout
    [auxio.sch, driver.sch, laser.sch, laserctrl.brd, laserctrl.sch, psu.sch, sd-isp.sch, temp-sensors.sch]
2012-10-17 Did some more V2 layout
    [auxio.sch, driver.sch, laser.sch, laserctrl.brd, laserctrl.sch, psu.sch, sd-isp.sch, temp-sensors.sch]
2012-10-21 Fixed the missing laser acceleration moves bug
2012-10-21 Finished the main part of board layout, only silkscreen remains now
    [laserctrl.brd]
2012-11-04 Added raster optimizer which merges all the rasters of similar properties that overlap in the y-axis into single rasters and made the distance scanned at constant speed be exactly the area needed for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
2012-11-24 Made the shaker ignore pixel overspeed by switching off the laser when engraving
2012-12-01 Exported 1g08 to a separate lib
    [auxio.sch, driver.sch, laser.sch, laserctrl.sch, psu.sch, sd-isp.sch, temp-sensors.sch, watchdog.sch]
2012-12-01 Use the 1g08 library
    [auxio.sch, driver.sch, laser.sch, laserctrl.sch, psu.sch, sd-isp.sch, temp-sensors.sch, watchdog.sch]
2013-01-27 I still fail at math
    [commander.c]
2013-01-28 Implemented simple checksumming on commands to guard against transmission errors
    [commander.c]
2013-01-29 Made the reply reader ignore any reply which is to the current command to avoid getting out of sync
    [commander.c]
2013-01-31 Fixed double Ready prompt that screwed up handshaking
    [commander.c]
2013-02-16 Fixed some cosmetic schematic issues
    [auxio.sch, driver.sch, laser.sch, laserctrl.sch, psu.sch, sd-isp.sch, temp-sensors.sch, watchdog.sch]
2013-02-16 Fixed silkscreen issues with values and references and labeled the auxio part of the gpio header
    [laserctrl.brd]
2013-02-16 Fixed molex pad problem in library
    [auxio.sch, driver.sch, laser.sch, laserctrl.brd, laserctrl.sch, psu.sch, sd-isp.sch, temp-sensors.sch]
2013-04-03 added flexbox.svg - an awesome case for the ISS lamp
2013-05-14 added flexcube for flexbox testing in 3mm acrylic
2013-09-11 - Remove svg file-list and replace with file-chooser dialog. - Make simulation draw exact move/cut/engrave paths
2014-09-12 removed adafruit_pi_box.svg from testdata because it is defective, use raspberry-pi-box.svg instead
2014-09-14 Started porting to the dropwizard web app framework, swagger still doesn't work
2014-10-03 Started playing with dropwizard views
    [laserctrl.brd]
2014-11-08 added engrave guide to host/testdata - goes from 200 to 700 mm/secc
2015-10-07 Opened laserctrl using 0.201507230931+5980~23~ubuntu14.10.1 and ordered a PCB from Dirty PCB
    [auxio.sch, driver.sch, laser.sch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]
2015-12-29 Switched to NRJavaSerial
2016-02-10 added new style: photonsaw-scale-power, when true, the laser power will be scaled by speed, when false the laser power will stay the same regardless of the speed
2016-02-10 Refactored to use LaserNodeSettings for rastering
2016-07-10 Switched to a legit ditherering implementation which is much, much faster
2016-07-16 Releasing v4 with some vital fixes for defeating over-optimization of very short moves, like those of the newly optimized rasterization
    [config.yaml]
2016-07-20 Upgraded tool chain
2016-08-02 Implemented laser gamma-correction LUT
    [commander.c, laser.c, laser.h, move.h]
2016-08-16 Added code to send the laser power LUT to the controller
2020-03-10 Added aiming shutter
    [aiming-shutter.fcstd, auxio.sch, driver.sch, hest.dxf, laser.sch, laserctrl.sch, mirror-plate.stl, psu.sch]
2020-03-10 Added the mirror holder as step
    [mirror-holder.step]
